jk1mly/pcb-audio-if/README.md

# pcb-audio-if

PCからのオーデイ信号の入出力と、無線機のマイク、スピーカを接続するインタフェース
簡易的（音を検波）なVOX機能を内蔵しているのでPCからPTT制御ができない場合にも使える
