jk1mly/pcb-audio-if/aud-if-doc.pdf

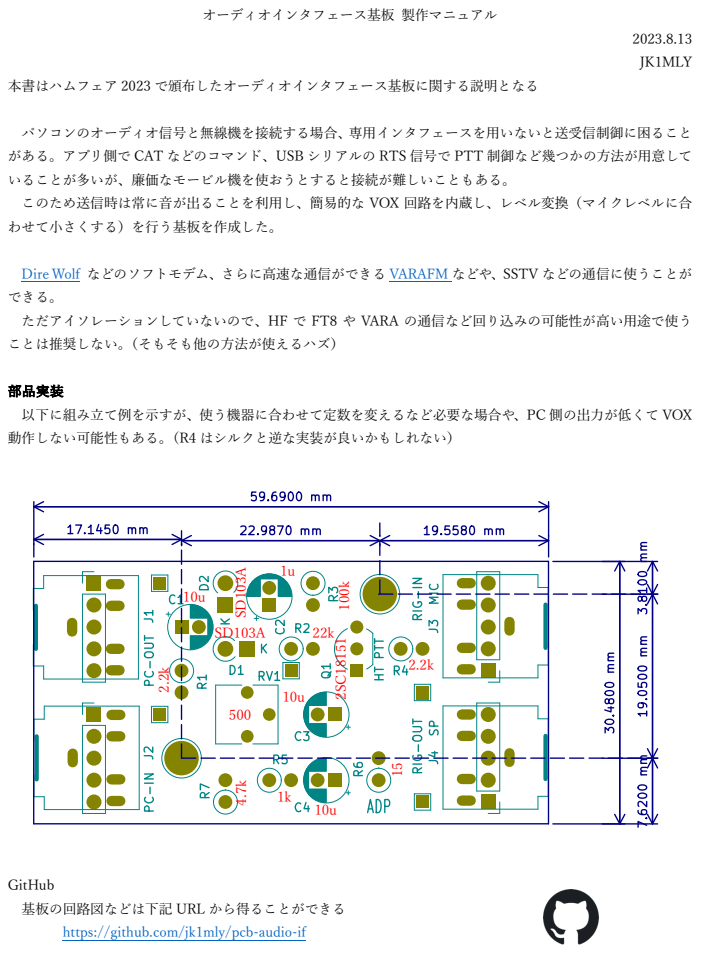
[picture p1: page 1]
オーディオインタフェース基板 製作マニュアル; JK1MLY; 本書はハムフェア 2023 で頒布したオーディオインタフェース基板に関する説明となる

パソコンのオーディオ信号と無線機を接続する場合、専⽤インタフェースを⽤いないと送受信制御に困ること
がある。アプリ側で CAT などのコマンド、USB シリアルの RTS 信号で PTT 制御など幾つかの⽅法が⽤意して
いることが多いが、廉価なモービル機を使おうとすると接続が難しいこともある。
このため送信時は常に⾳が出ることを利⽤し、簡易的な VOX 回路を内蔵し、レベル変換（マイクレベルに合
わせて⼩さくする）を⾏う基板を作成した。

Dire Wolf などのソフトモデム、さらに⾼速な通信ができる VARAFM などや、SSTV などの通信に使うことが
できる。
ただアイソレーションしていないので、HF で FT8 や VARA の通信など回り込みの可能性が⾼い⽤途で使う
ことは推奨しない。（そもそも他の⽅法が使えるハズ）

部品実装
以下に組み⽴て例を⽰すが、使う機器に合わせて定数を変えるなど必要な場合や、PC 側の出⼒が低くて VOX
動作しない可能性もある。（R4 はシルクと逆な実装が良いかもしれない）

https://github.com/jk1mly/pcb-audio-if ².2

GitHub
基板の回路図などは下記 URL から得ることができる

部品リスト

秋⽉電⼦で部品を揃える場合の通販コードを添えた部品リストを以下に⽰す。 あまり定数はシビアでないので、⼿持ち部品で適当に組んでも⼤丈夫だと思う。 最近のハンディ機の場合は VOX 機能を持つ場合が多いが、持っていない場合はメーカに応じた R4 を実装す ることでマイク＋PTT のラインに接続できる。確認しているのは YAESU の VX-8 のみで 2.2k を⽤いた。 C2 が VOX のディレイタイムなので⻑い or 短いときには値を増減する。
ケースに⼊れる場合は 3.5mm コネクタを実装せず、⽤意してあるランドからケースに取り付けたコネクタま で配線する。
C1 | 10u | P-17897 | Q1 | 2SC1815 | I-06477
C2 | 1u | P-17889 | R1 | 4.7k | R-25472
C3 | 10u | P-17897 | R2 | 22k | R-25223
C4 | 10u | P-17897 | R3 | 100k | R-25103
D1 | SD103A | I-04271 | R4 | 2.2k | R-25222
D2 | SD103A | I-04271 | R5 | 4.7k | R-25472
J1 | AudioJack | C-12478 | R6 | 15 | R-25150
J2 | AudioJack | C-12478 | R7 | 1k | R-25102
J3 | AudioJack | C-12478 | RV1 | 500 | P-14900
J4 | AudioJack | C-12478

組み上げ例

実験⽤にケースに⼊れない場合は下図のような実装になる。
ケースに⼊れる場合はタカチの SW-65(P-15128)に⼊れ、パネル⽤の 3.5mm(C-06257)と 2.5mm(C-15496)の コネクタを使うことで想定している。（実機での確認は未実施）

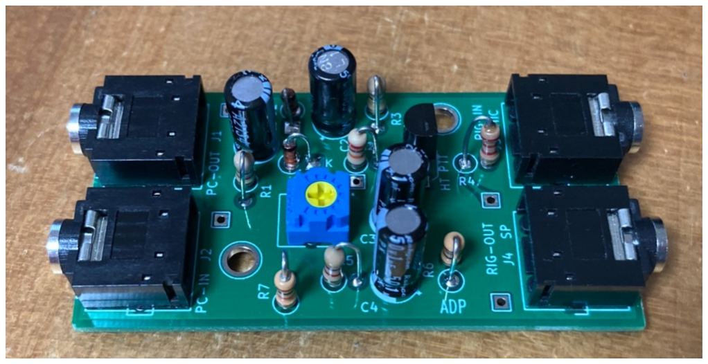
[picture p2: figure]
