jk1mly/pcb-audio-if/aud-if-sch.pdf

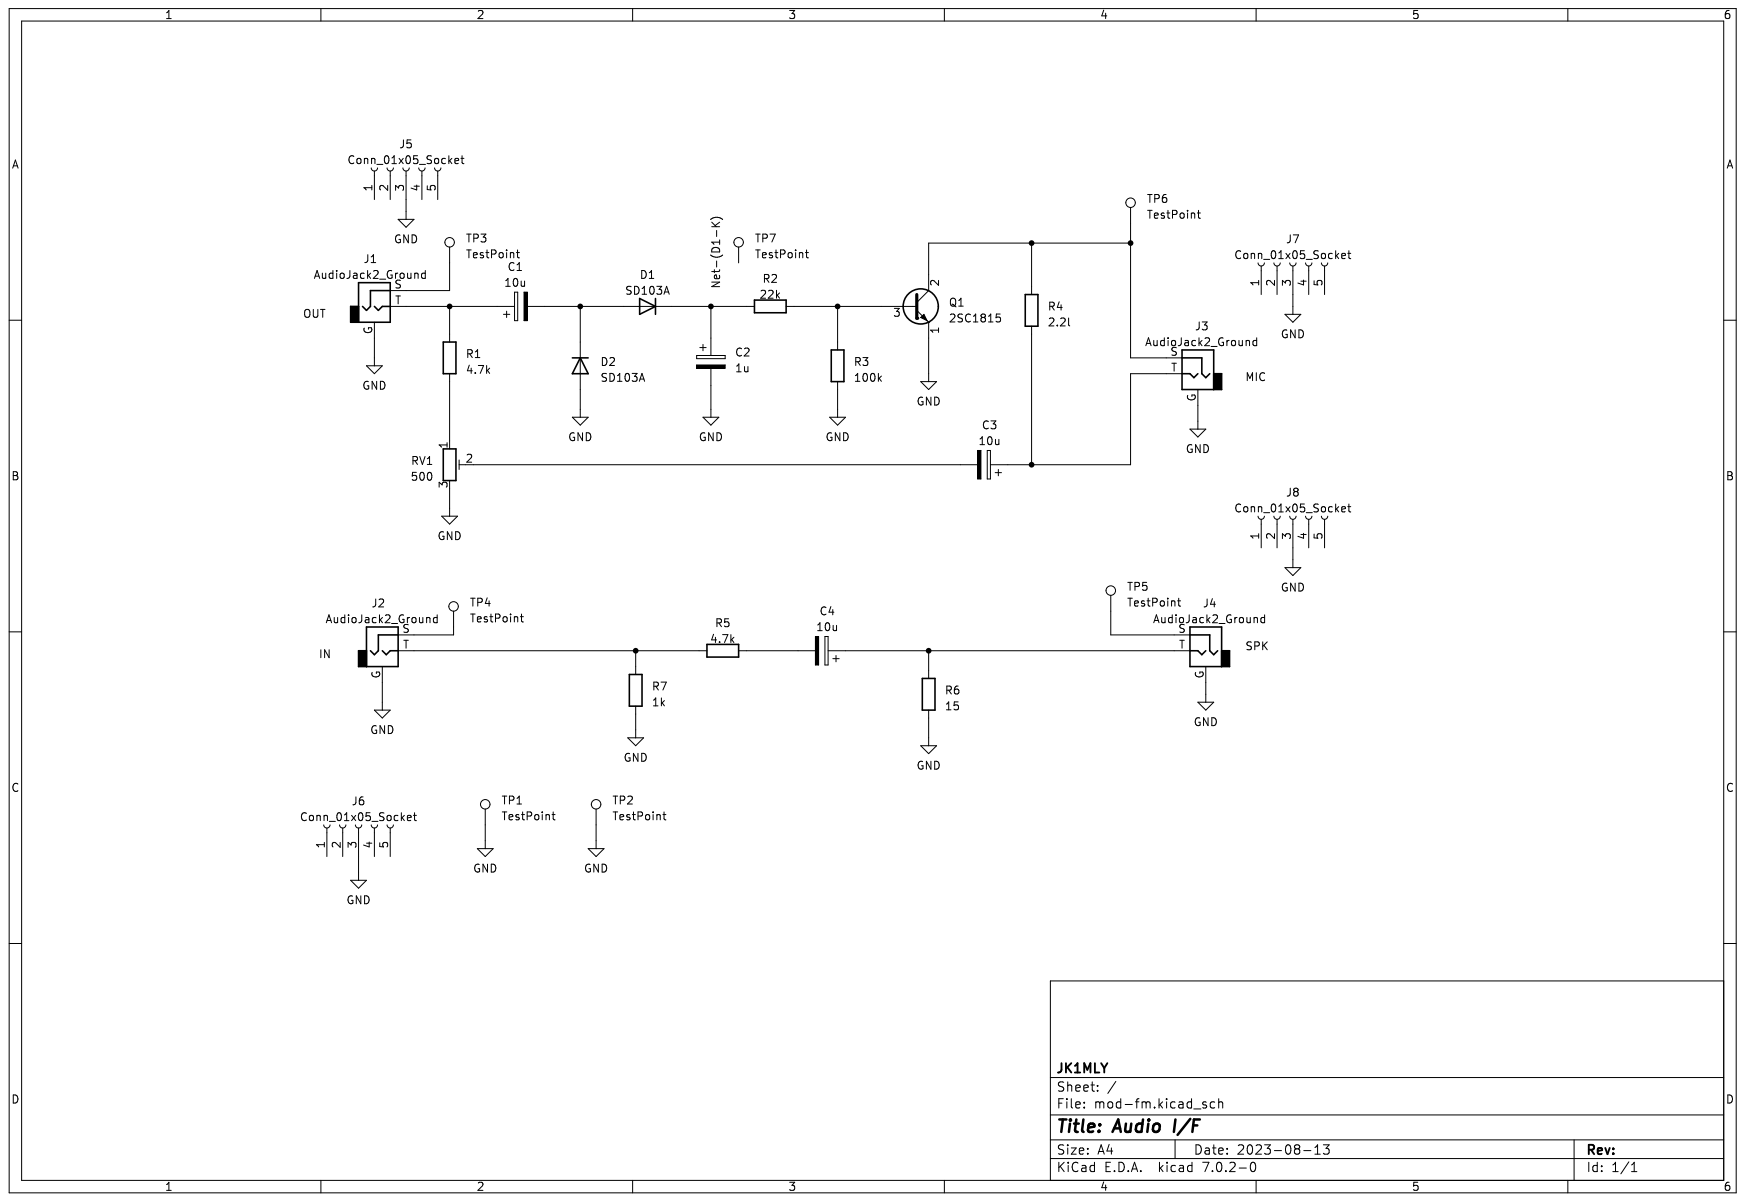
[picture p3: page 1]
