jk1mly/pcb-audio-if/mod-fm.kicad_pcb

## KiCad design mod-fm.kicad_pcb (2023-08-13)

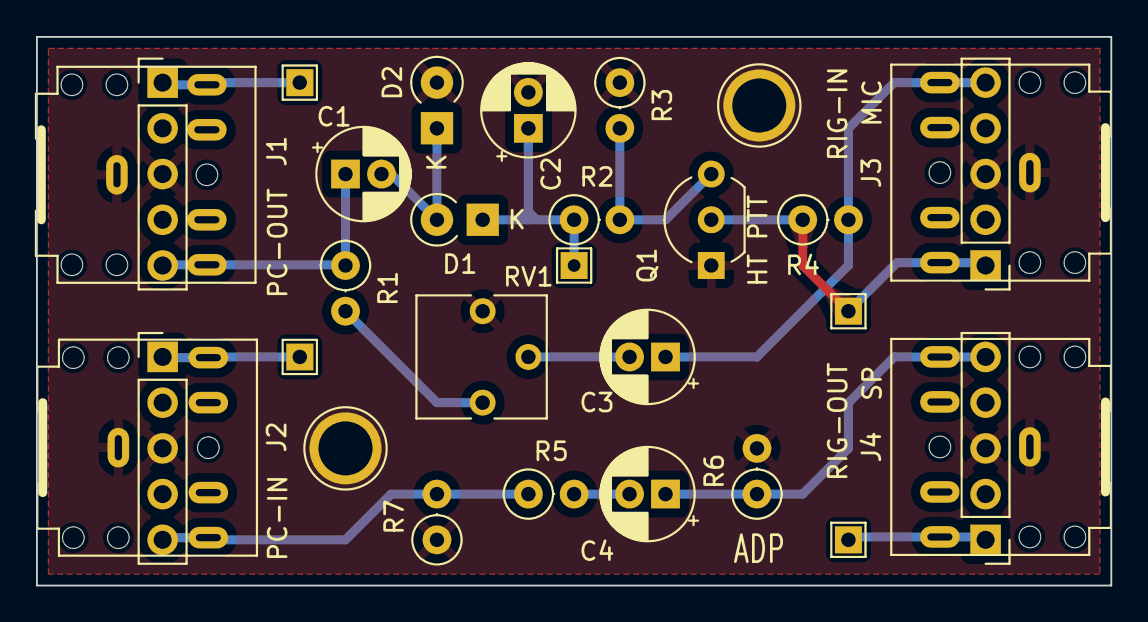
[picture p4: board mod-fm.kicad_pcb from above]

Board: 2 copper layers, 59.7 x 30.5 mm, 30 parts (0 on the bottom side), 15 nets.

Parts:
C1, C2, C3, C4: C_Polarized; CP_Radial_D5.0mm_P2.00mm
D1, D2: Diode; D_A-405_P2.54mm_Vertical_KathodeUp
J1, J2, J3, J4: AudioJack2_Ground; Jack_3.5mm_CUI_SJ1-3525N_Horizontal
J5, J6, J7, J8: Conn_01x05_Socket; PinHeader_1x05_P2.54mm_Vertical
Q1: 2SC1815; TO-92_Inline_Wide
R1, R2, R3, R4, R5, R6, R7: R; R_Axial_DIN0207_L6.3mm_D2.5mm_P2.54mm_Vertical
RV1: R_Potentiometer_Trim; Potentiometer_Vishay_T73YP_Vertical
TP1, TP2: TestPoint; TestPoint_Plated_Hole_D3.0mm
TP3, TP4, TP5, TP6, TP7: TestPoint; TestPoint_THTPad_1.5x1.5mm_Drill0.7mm

Connections:
GND: C2.2, D2.2 (A), J1.G, J2.G, J3.G, J4.G, J5.3, J6.3, J7.3, J8.3, Q1.1 (E), R3.1, R6.2, R7.1, RV1.3, TP1.1, TP2.1
unnamed: C1.1, J1.T, R1.1
unnamed: C3.1, J3.T, R4.2
unnamed: C3.2, RV1.2
unnamed: C4.1, J4.T, R6.1
unnamed: C4.2, R5.2
unnamed: C1.2, D1.2 (A), D2.1 (K)
unnamed: C2.1, D1.1 (K), R2.1, TP7.1
unnamed: J1.S, TP3.1
unnamed: J2.S, TP4.1
unnamed: J2.T, R5.1, R7.2
unnamed: J4.S, TP5.1
unnamed: Q1.3 (B), R2.2, R3.2
unnamed: J3.S, Q1.2 (C), R4.1, TP6.1
unnamed: R1.2, RV1.1
